Asongnabrilan-nso/PlastiWatch/README.md

# Plastiwatch
Edge AI powered smart watch.
