Asongnabrilan-nso/PlastiWatch/C++_v1/stl/PlastiWatch-pic1.png

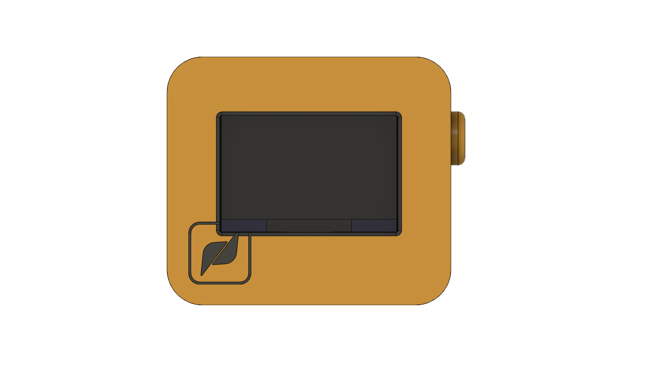
C++_v1/stl/PlastiWatch-pic1.png
