Asongnabrilan-nso/PlastiWatch/C++_v1/stl/PlastiWatch-pic2.png

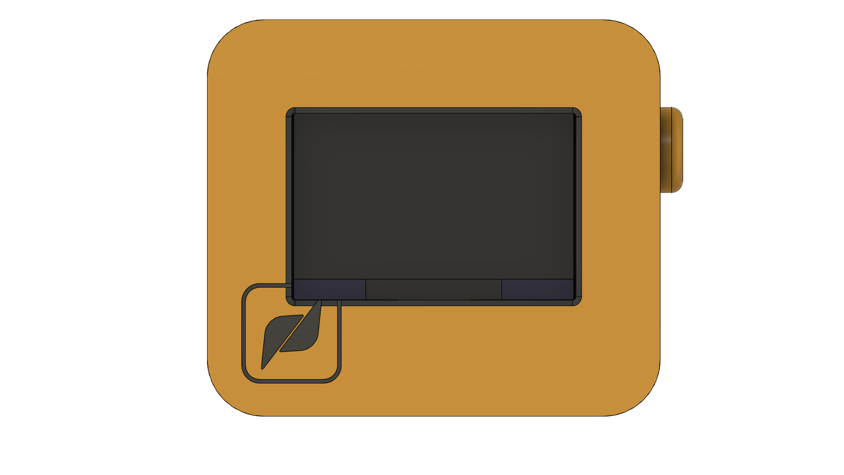
C++_v1/stl/PlastiWatch-pic2.png
