Asongnabrilan-nso/PlastiWatch/C++_v1/stl/PlastiWatch-pic3.png

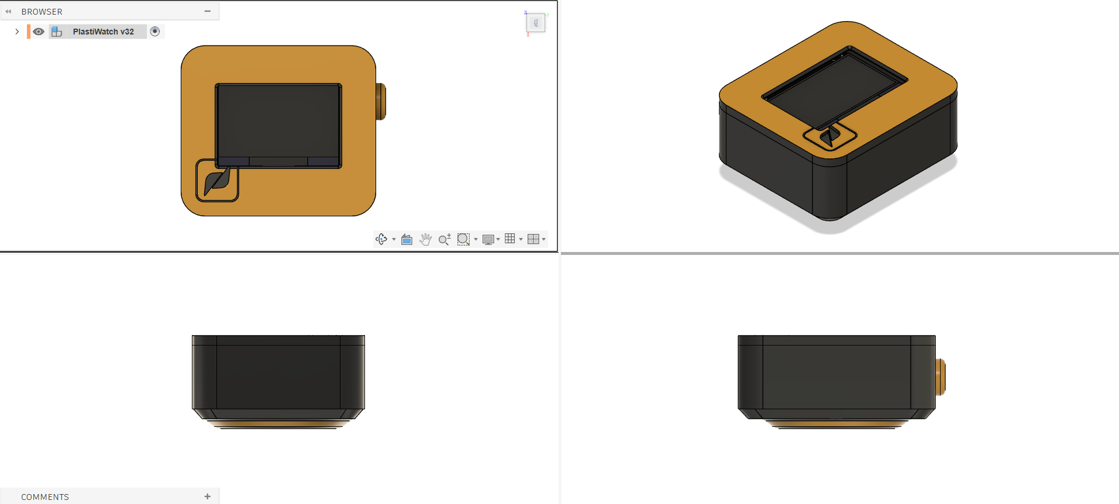
C++_v1/stl/PlastiWatch-pic3.png
