Asongnabrilan-nso/PlastiWatch/C++_v1/stl/PlastiWatch-pic4.png

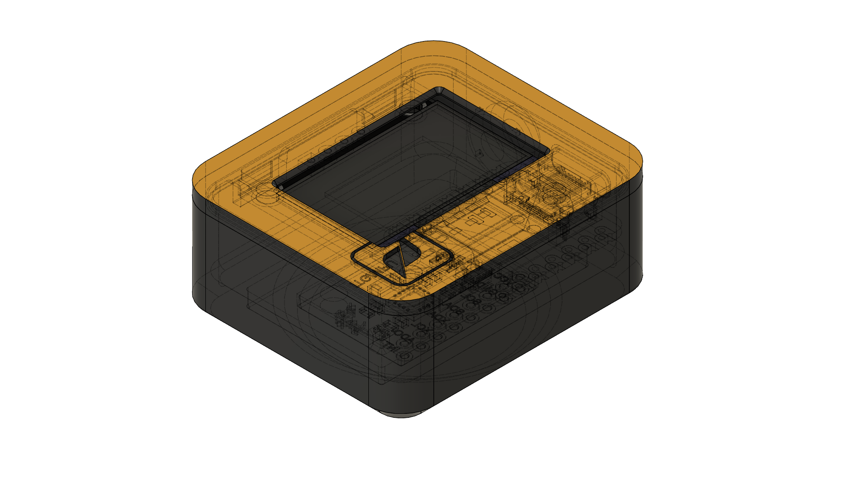
C++_v1/stl/PlastiWatch-pic4.png
