Asongnabrilan-nso/PlastiWatch/C++_v1/stl/PlastiWatch-pic5.png

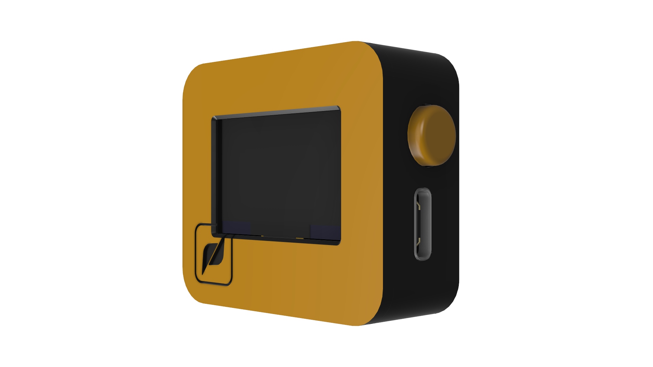
C++_v1/stl/PlastiWatch-pic5.png
