Asongnabrilan-nso/PlastiWatch/C++_v1/stl/Watch Top_v2.stl

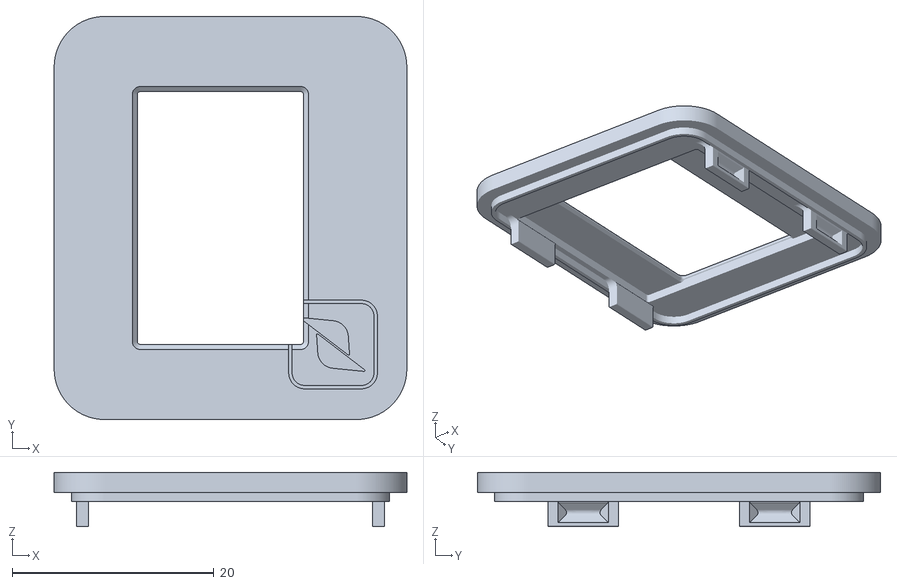
[picture p21: CAD file, 2026-01-31]
C++_v1/stl/Watch Top_v2.stl
35.0 x 40.0 x 5.40
