Asongnabrilan-nso/PlastiWatch/C++_v1/stl/Watch Top.stl

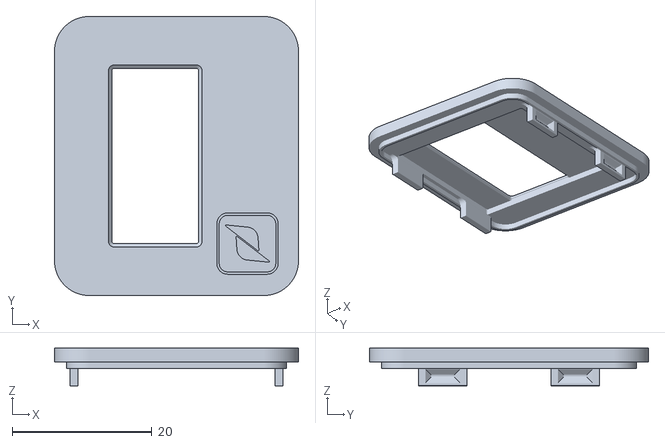
[picture p22: CAD file, 2026-01-31]
C++_v1/stl/Watch Top.stl
35.0 x 40.0 x 5.40
