Asongnabrilan-nso/PlastiWatch/C++_v1/stl/Button.stl

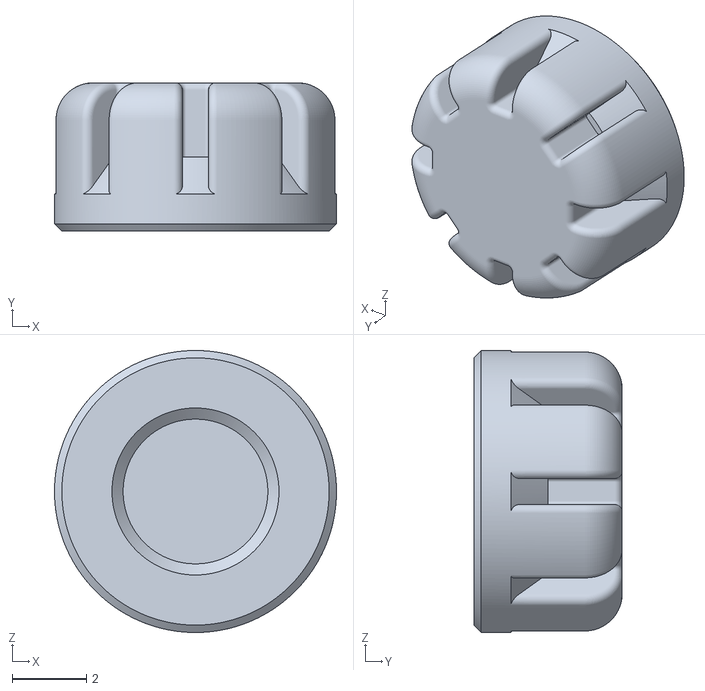
[picture p23: CAD file, 2026-01-26]
C++_v1/stl/Button.stl
7.60 x 4.00 x 7.60
