Asongnabrilan-nso/PlastiWatch/stl/PlastiWatch v14.stl

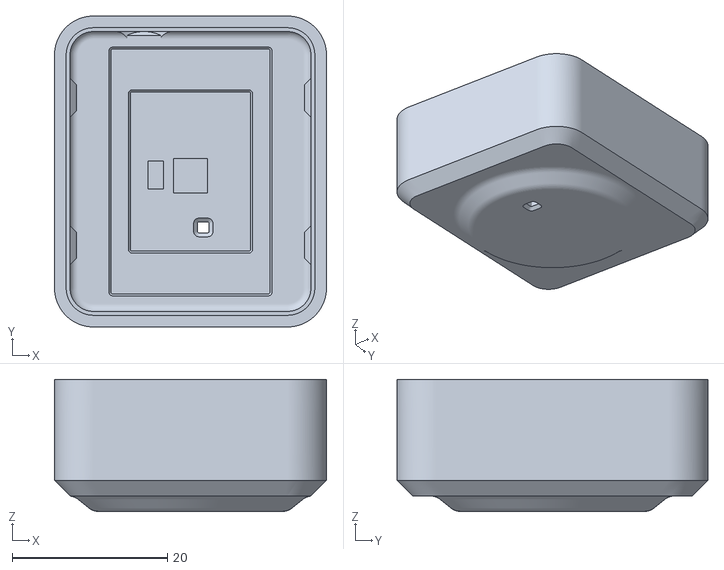
[picture p24: CAD file, 2026-01-26]
stl/PlastiWatch v14.stl
35.0 x 40.0 x 17.0
