Asongnabrilan-nso/PlastiWatch/stl/Watch Body.stl

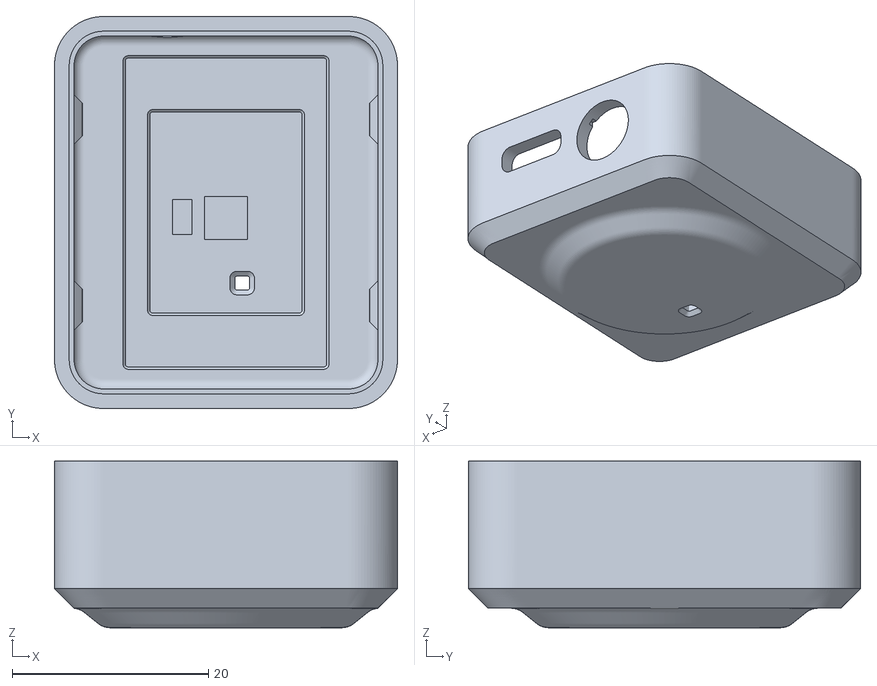
[picture p25: CAD file, 2026-01-26]
stl/Watch Body.stl
35.0 x 40.0 x 17.0
