Asongnabrilan-nso/PlastiWatch/C++_v1/stl/PlastiWatch.step

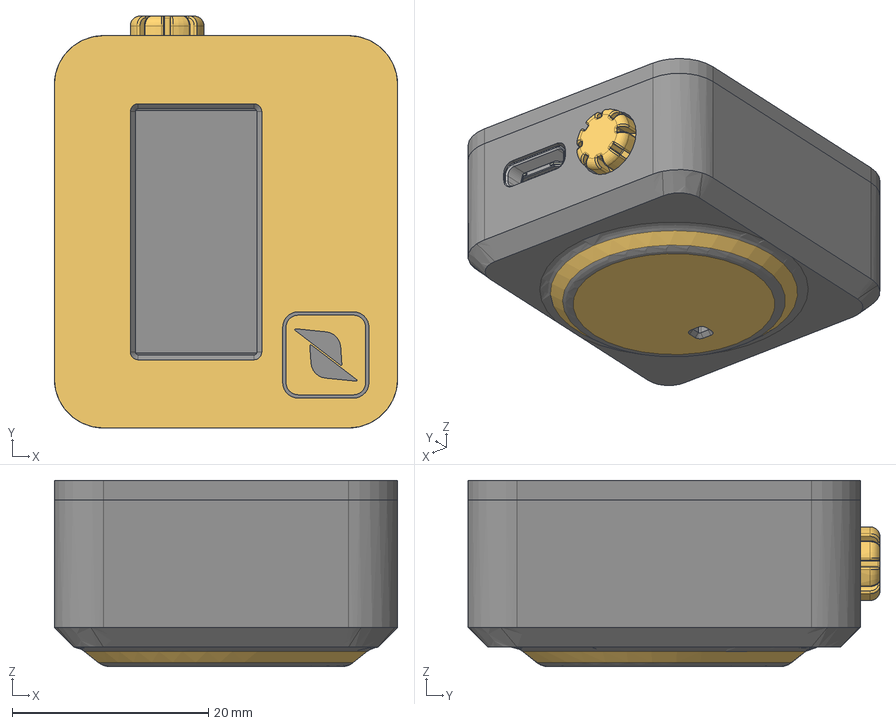
[picture p26: CAD file, 2026-01-26]
C++_v1/stl/PlastiWatch.step
35.0 x 42.0 x 19.0 mm
Body - PCB
Body - Back Panel
Body - Adhesive Pad
Body - Front Panel
Body - Flex Connector Bend
Body - Flex Connector Terminals
Body - Black Tape
Body - Protective Foil
Body - Screen Border
Extrude - Annular Rings
PCB
trou1
trou002
trou003
trou004
trou005
trou006
trou007
trou008
Text_X
Symb_Y
Symb_X
Text_Y
Text_VCC
Text_GND
Text_SCL
Text_SDA
Text_XDA
Text_XCL
Text_ADO
Text_INT
R_0603_1608Metric
R_0603_1608Metric001
R_0603_1608Metric002
R_0603_1608Metric003
C_0603_1608Metric
C_0603_1608Metric001
C_0603_1608Metric002
C_0603_1608Metric003
Corps002
C_0603_1608Metric004
C_0603_1608Metric005
LED_0603_1608Metric_Castellated
QFN_16_1EP_4x4mm_P065mm_EP21x21mm
Text_ITGMPU
SOT_23_5
Corps001
Button
BOSS-EXTRUDE14_8_
BOSS-EXTRUDE7_4_
BOSS-EXTRUDE7_3_
BOSS-EXTRUDE14_4_
BOSS-EXTRUDE14_2_
BOSS-EXTRUDE14_11_
BOSS-EXTRUDE7_7_
BOSS-EXTRUDE14_9_
BOSS-EXTRUDE14_3_
BOSS-EXTRUDE14_7_
MIRROR2
BOSS-EXTRUDE14_5_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
