Asongnabrilan-nso/PlastiWatch/(list of files, cad)

Other CAD files:
C++_v1/stl/PlastiWatch.f3z
stl/PlastiWatch.f3z
