Asongnabrilan-nso/PlastiWatch/(list of files, drawings)

Other design files:
C++_v1/plastiwatch_firmware/electronics/wiring.fzz
plastiwatch_firmware/electronics/wiring.fzz
