Asongnabrilan-nso/PlastiWatch/C++_v1/test/MPU6050_6_axes_data/MPU6050_6_axes_data.ino

#include <Adafruit_MPU6050.h>
#include <Adafruit_Sensor.h>
#include <Wire.h>

Adafruit_MPU6050 mpu;

void setup() {
  Serial.begin(115200);
  while (!Serial) delay(10); 

  // XIAO ESP32C3 I2C Pins
  Wire.begin(D4, D5); 

  if (!mpu.begin()) {
    Serial.println("Failed to find MPU6050 chip");
    while (1) delay(10);
  }

  // Setup range and bandwidth
  mpu.setAccelerometerRange(MPU6050_RANGE_8_G);
  mpu.setGyroRange(MPU6050_RANGE_500_DEG);
  mpu.setFilterBandwidth(MPU6050_BAND_21_HZ);
}

void loop() {
  sensors_event_t a, g, temp;
  
  // We MUST ask for temp to satisfy the library, but we won't use it.
  mpu.getEvent(&a, &g, &temp);

  // Print ONLY Accel and Gyro data (6 columns)
  Serial.print(a.acceleration.x); Serial.print(",");
  Serial.print(a.acceleration.y); Serial.print(",");
  Serial.print(a.acceleration.z); Serial.print(",");
  Serial.print(g.gyro.x);         Serial.print(",");
  Serial.print(g.gyro.y);         Serial.print(",");
  Serial.println(g.gyro.z);       // End line here, NO temp data

  delay(16); // ~60Hz sampling
}
