Asongnabrilan-nso/PlastiWatch/C++_v1/test/baterry-monitor/baterry-monitor.ino

void setup() {
  Serial.begin(115200);
  pinMode(A0, INPUT);         // ADC
}

void loop() {
  uint32_t Vbatt = 0;
  for(int i = 0; i < 16; i++) {
    Vbatt = Vbatt + analogReadMilliVolts(A0); // ADC with correction   
  }
  float Vbattf = 2 * Vbatt / 16 / 1000.0;     // attenuation ratio 1/2, mV --> V
  Serial.println(Vbattf, 3);
  delay(1000);
}
